vmihda/matter-air-quality-sensor/firmware/components/aq_drivers/scd41.c

#include "scd41.h"

#include "driver/i2c_master.h"
#include "esp_check.h"
#include "i2c_bus.h"
#include "scd4x_proto.h"

#define SCD41_ADDRESS 0x62
#define SCD41_TIMEOUT_MS 100

#define CMD_START_PERIODIC 0x21B1
#define CMD_READ_MEASUREMENT 0xEC05
#define CMD_STOP_PERIODIC 0x3F86
#define CMD_DATA_READY 0xE4B8
#define CMD_GET_SERIAL 0x3682
#define CMD_SET_TEMP_OFFSET 0x241D

// Execution times from the SCD4x datasheet.
#define STOP_DELAY_MS 500
#define COMMAND_DELAY_MS 1

static const char *TAG = "scd41";

static i2c_master_dev_handle_t s_device;

static esp_err_t send_command(uint16_t command)
{
    const uint8_t bytes[2] = {command >> 8, command & 0xFF};
    return i2c_master_transmit(s_device, bytes, sizeof(bytes), SCD41_TIMEOUT_MS);
}

static esp_err_t read_response(uint16_t command, uint8_t *response, size_t length)
{
    ESP_RETURN_ON_ERROR(send_command(command), TAG, "command 0x%04X failed", command);
    AQ_WAIT_MS(COMMAND_DELAY_MS);
    return i2c_master_receive(s_device, response, length, SCD41_TIMEOUT_MS);
}

static esp_err_t create_device(int sda_gpio, int scl_gpio)
{
    if (s_device != NULL) {
        return ESP_OK;
    }
    i2c_master_bus_handle_t bus = NULL;
    ESP_RETURN_ON_ERROR(aq_i2c_bus_get(sda_gpio, scl_gpio, &bus), TAG, "bus init failed");

    return aq_i2c_add_device(bus, SCD41_ADDRESS, &s_device);
}

esp_err_t scd41_init(int sda_gpio, int scl_gpio)
{
    ESP_RETURN_ON_ERROR(create_device(sda_gpio, scl_gpio), TAG, "I2C setup failed");

    // The sensor keeps measuring across an MCU reset, and most commands need it idle.
    ESP_RETURN_ON_ERROR(send_command(CMD_STOP_PERIODIC), TAG, "no reply from SCD41, check wiring");
    AQ_WAIT_MS(STOP_DELAY_MS);
    return ESP_OK;
}

esp_err_t scd41_get_serial(uint64_t *serial)
{
    uint8_t raw[9];
    ESP_RETURN_ON_ERROR(read_response(CMD_GET_SERIAL, raw, sizeof(raw)), TAG, "serial read failed");
    return scd4x_decode_serial(raw, serial) ? ESP_OK : ESP_ERR_INVALID_CRC;
}

esp_err_t scd41_set_temp_offset(float offset_c)
{
    const uint16_t word = scd4x_encode_temp_offset(offset_c);
    uint8_t bytes[5] = {CMD_SET_TEMP_OFFSET >> 8, CMD_SET_TEMP_OFFSET & 0xFF, word >> 8, word & 0xFF, 0};
    bytes[4] = scd4x_crc8(&bytes[2], 2);
    ESP_RETURN_ON_ERROR(i2c_master_transmit(s_device, bytes, sizeof(bytes), SCD41_TIMEOUT_MS), TAG, "offset write failed");
    AQ_WAIT_MS(COMMAND_DELAY_MS);
    return ESP_OK;
}

esp_err_t scd41_start(void)
{
    return send_command(CMD_START_PERIODIC);
}

esp_err_t scd41_read(float *co2_ppm, float *temp_c, float *rh_pct)
{
    uint8_t ready[3];
    ESP_RETURN_ON_ERROR(read_response(CMD_DATA_READY, ready, sizeof(ready)), TAG, "data ready failed");
    bool data_ready = false;
    if (!scd4x_decode_data_ready(ready, &data_ready)) {
        return ESP_ERR_INVALID_CRC;
    }
    if (!data_ready) {
        return ESP_ERR_NOT_FOUND;
    }

    uint8_t raw[9];
    ESP_RETURN_ON_ERROR(read_response(CMD_READ_MEASUREMENT, raw, sizeof(raw)), TAG, "measurement read failed");
    return scd4x_decode_measurement(raw, co2_ppm, temp_c, rh_pct) ? ESP_OK : ESP_ERR_INVALID_CRC;
}
