vmihda/matter-air-quality-sensor/(commit log)

2026-11-06 chore: add ESP-IDF project skeleton for esp32c6
    [partitions.csv]
2026-11-06 feat: add SCD41 and PMS5003 drivers with bring-up mode
2026-11-06 feat: run sensors, alerts and status LED in product firmware
2026-11-06 feat: add device web page, settings, updates, S3 test build and ENS160
    Combines these steps, whose intermediate device page was not in Ukrainian yet:
    - feat: add device web page, settings, updates and service console
    - fix: make firmware confirmation and runtime setting changes safe
    - chore: build the demo firmware for an ESP32-S3 test board
    - feat: add ENS160 VOC, PM1 and PM10, remove contact sensors, redo device page
    [partitions.csv]
2026-11-06 feat: delay the Poor level with hold times set on the device page
    A value at the Poor threshold now counts as Moderate until its hold has
    passed, 2 minutes for CO2 and 5 minutes for PM2.5 by default, and Poor
    clears only below Moderate. The level sent to Home no longer flickers
    around a threshold, so automations do not fire repeatedly.
    [service_console.cpp, web_ui.cpp]
2026-11-06 feat: add parametric printable enclosure with geometry tests and 3D preview
2026-11-06 feat: check that LED light leaves the enclosure and show USB-C, LED and buttons in the preview
2026-11-06 fix: route every wire through the enclosure and move the passage above the adapter
2026-11-06 fix: make the lid closable, seal the PMS ports and separate crossing wires after review
2026-11-06 fix: lengthen rear snaps and clear the sensor connector after second review
2026-11-06 feat: show foam tape and heat shrink in the model and record checked part lots
2026-11-10 docs: add enclosure notes, the simulation guide and the Ukrainian 3D page
2026-11-10 docs: add a README with parts, wiring, build and enclosure steps
